aaravs-s/pharmatech/README.md

# pharmatech

Boilerplate repository structure for a pill compounding machine project.

## Top-level areas
- `cad/` - mechanical and enclosure design files
- `firmware/` - embedded software and configuration
- `electronics/` - schematic, PCB, and component documentation
