aaravs-s/pharmatech/electronics/README.md

# Electronics

Electrical design artifacts for control, power, and interface circuitry.

## Layout
- `schematics/` - source schematic files
- `pcb/` - PCB layout files and fabrication outputs
- `bom/` - bill of materials and sourcing sheets
- `simulation/` - circuit simulation setups and outputs
- `docs/` - electronics-specific engineering notes
