aaravs-s/pharmatech/cad/README.md

# CAD

Mechanical design assets for the pill compounding machine.

## Layout
- `models/` - parametric and solid model source files
- `drawings/` - manufacturing drawings and assembly views
- `exports/` - neutral exchange formats (STEP/STL/OBJ)
- `docs/` - CAD-specific notes and design decisions
