aaravs-s/pharmatech/firmware/README.md

# Firmware

Embedded software for machine control, sensing, and dosing logic.

## Layout
- `src/` - application source code
- `include/` - public headers and shared interfaces
- `config/` - board and environment configuration
- `tests/` - firmware-focused tests and test fixtures
- `docs/` - protocol and architecture notes
