aaravs-s/pharmatech/docs/journal-reference/entries/R07_model_the_two_arm_agitator_and_compare_uniform_and_tapered_flight_concepts.md

# R07 Model the two-arm agitator and compare uniform and tapered-flight concepts

> **AI-assisted reference draft — not a submitted work log.** This reconstruction is for writing your own journal from your actual work. Work dates, active hours, missing measurements, and test claims must be completed from your records. Archived CAD screenshots were captured retrospectively on October 13, 2026; they are not original screenshots from the design session.

Milestone 1 · Previous topics J12

Work date: [your actual date]
Active work time: [your actual hours; group/split by real sessions]

## Objective

Add hopper circulation to the auger drive and preserve the distinction between a modeled configuration and a proposed alternative.

## Design process

I developed agitator arms that could rotate with the auger-related drive component. The additional design note asks for two agitators attached to the rotating piece so both the auger and agitation move together. The saved CAD views show an auger with two triangular arms, which gives me a concrete image for explaining that arrangement.

I also explored a second auger configuration with flights that taper rather than remaining uniform along the shaft. The purpose was to compare feeding geometries instead of assuming the first spiral shape would suit every powder. The design note describes the intended alternatives, but it does not confirm that both were printed or tested successfully.

The arm geometry needs to be described in relation to the hopper: sweep diameter, axial position, clearance from the walls, and the connection that transfers torque. Those dimensions determine what material the agitator can disturb. This update is a useful place to separate a CAD proposal from the version that eventually ran in a physical powder test.

## Construction and implementation detail

The planning note proposed attaching the agitator beneath the rotating blue component so that one rotating connection could turn both the auger and agitation features. It called for two arms and two configurations: a screw similar to the existing one with added agitators, and another with flights that funnel downward. That note is specific about the intended relationship among parts but does not demonstrate that both configurations were successfully printed and tested.

The V5 feature history shows the arm geometry in Sketch 10 on the Top plane. The construction view highlights the arm profiles around the existing shaft and screw. Extrude 8 then selects two faces of that sketch, uses Add, enables Symmetric extrusion, sets the displayed depth to 0.318 cm, and merges into the part named tube adapter. The archived depth is approximately 3.18 mm. Recreating this feature requires the arm sketch and merge target as well as the thickness.

The open triangular arms shown in the model expand the rotating sweep beyond the screw itself. Their purpose is to encounter powder outside the narrow auger region and cycle it toward the feeder. Arm reach therefore has to be assessed in the hopper's coordinate system rather than judged from the isolated part. A good assembly check would display the hopper wall and the arm envelope together and measure the minimum gap around a full rotation.

I kept the uniform screw and tapered proposal distinct in the reference sequence. The recovered Helix 1 uses one target pitch along a defined height, whereas the planning text requests a funneling variation. Without the separate alternative's feature definition or print image, I cannot use the constant-pitch sweep screenshot as proof of a tapered flight. The image placeholder names the missing alternative rather than implying it is in the final view.

Adding arms also introduced a mechanical load change. The drive now moved the screw and encountered powder through the agitator at the same time. That made loaded rotation, powder accumulation near the arm roots, and the printed attachment points relevant to later speed testing. The notes describe agitation helping with clumps, but do not record stresses or a measured power comparison.

This completed the mechanical reasoning needed to enter closed-loop development: a single powder path, an auger that could be driven, and an agitation concept addressing stagnant material. M2 still required independent work on wiring, reading the scale, selecting commands, and stopping correctly. Those stages follow as individual detailed updates rather than one jump from finished mechanism to working electronics.

## Image sequence

V5 agitator: Sketch 10 highlights the two arm profiles before Extrude 8, with the earlier screw geometry present.

V5 agitator: Sketch 10 highlights the two arm profiles before Extrude 8, with the earlier screw geometry present.

V5 agitator: Extrude 8 adds two sketch faces symmetrically at 0.318 cm depth into tube adapter. The archived tree shows feature warnings, not a fully validated assembly.

V5 agitator: Extrude 8 adds two sketch faces symmetrically at 0.318 cm depth into tube adapter. The archived tree shows feature warnings, not a fully validated assembly.

V5 Part Studio 1, saved July 2 2026. Auger geometry with two agitator arms.

V5 Part Studio 1, saved July 2 2026. Auger geometry with two agitator arms.

V10 Part Studio 1, saved July 10 2026. Later view of the auger and agitator arms.

V10 Part Studio 1, saved July 10 2026. Later view of the auger and agitator arms.

## Result and handoff

The V5 archive contains a two-arm agitator constructed from a sketch and symmetric additive extrusion. The separate tapered-flight concept still needs its own model and test evidence.

## Complete from your records

Add arm tip radius, measured wall clearance, attachment geometry, printed revision, and observed results for each of the two proposed configurations.

[IMAGE PLACEHOLDER: Assembly section showing agitator tips relative to the hopper wall throughout rotation.]

[IMAGE PLACEHOLDER: Tapered-flight alternative: its generating sketch/path, intermediate solid, finished CAD, and printed comparison.]

## Sources

- [M1 - MECHANICAL DOSER](https://docs.google.com/document/d/1VJVmuO_Wsarp4JEZYmcffV4hj5R7lj_xGEI08EhueAM/edit)
- [STUFF TO FIX TONIGHT](https://docs.google.com/document/d/1usu-M_TCbRc7j5A3ndAVeFQoTAXTW40O4JjwxquL32A/edit)

[All reference drafts](../README.md) · [Image URLs](../IMAGE_URLS.md) · [Project journal](../../../JOURNAL.md)
