aaravs-s/pharmatech/Images/CadModel.png

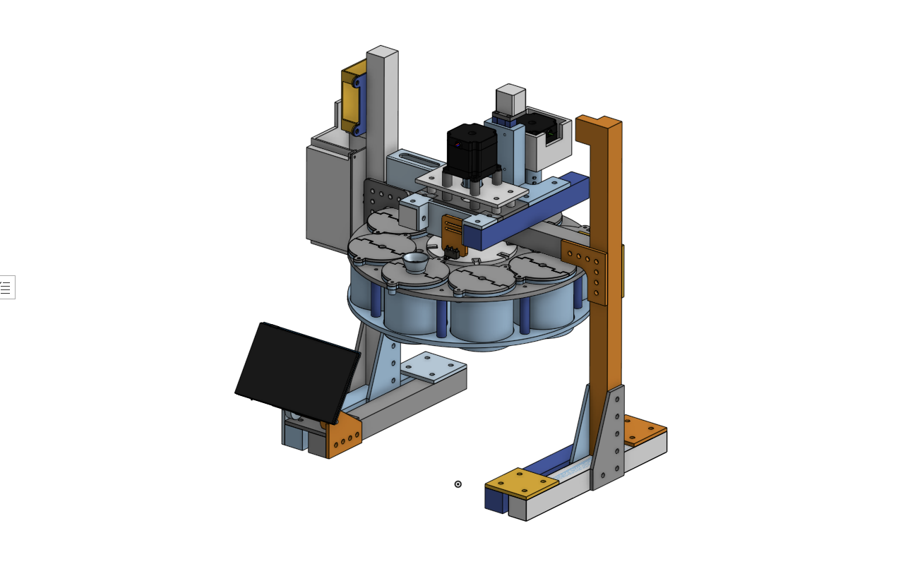
Images/CadModel.png
