aaravs-s/pharmatech/docs/journal-reference/session_worksheet.csv

Reference update | Title | Previous outline topics | Actual session date | Actual active hours | Split/combined session | Files/revisions used | Measured result | Missing evidence supplied
R01 | Define the requirements and develop the shared eight-hopper architecture | J01; J02; J03
R02 | Construct the first hopper, adapter, and bottom-feeder CAD | J05
R03 | Build the auger from a helix and flight profile, then obtain a usable print | J04
R04 | Test the removable threaded hopper and replace it with a short locking interface | J06; J07
R05 | Simplify the powder path and reduce sugar leaking during loading | J08; J09
R06 | Diagnose cornstarch jamming and the first agitator's incomplete coverage | J10; J11
R07 | Model the two-arm agitator and compare uniform and tapered-flight concepts | J12
R08 | Wire the first NEMA 17 and TMC2209 drive and establish controlled motion | J13
R09 | Read serial scale data and establish the baseline mass for each dispense | J14
R10 | Build the touchscreen workflow and hand targets to a separate controller process | J15; J16
R11 | Replace continuous feeding near the target with stop, settle, and pulse phases | J17
R12 | Separate powder behavior into configurable motion and settling profiles | J18
R13 | Stop unwanted motion after program termination and add layered shutdown behavior | J19
R14 | Plan the electronics mounting and PCB while the control system is still changing | J20
R15 | Investigate loaded speed limits and upgrade the NEMA 17 drive | J21; J22
R16 | Make phase thresholds depend on dose size: the July 21 to July 24 controller revision | J23
R17 | Replace the barcode plan with selectable profiles and run the doser from the Pi | J24; J25
R18 | Measure 5 g performance with sugar, salt, cocoa, and cinnamon | J26; J27
R19 | Validate 5 g dispensing of the four cohesive powders | J28
R20 | Evaluate the 0.055 g limit and separate accuracy from repeatability | J29; J30
R21 | Build the solid eight-pocket carousel and evolve it into an open two-plate structure | J31
R22 | Develop the lift mechanism that clears the drive before indexing | J32
R23 | Replace the angle-sensitive drive coupling with serrated mating teeth | J33; J34
R24 | Construct the extrusion frame and integrate the carousel, scale, lift, and screen | J35; J36
R25 | Convert carousel positions to step counts and establish a known reference | J37; J38
R26 | Choose the shortest carousel route and wait for completed indexing | J39
R27 | Sequence lift, indexing, engagement, and mass feedback for a multi-powder recipe | J40
R28 | Move STEP generation from the software loop to hardware timers | J41; J42
R29 | Add driver-alarm handling and an interactive motor-speed test | J43
R30 | Drop the fixed-board plan, troubleshoot perfboard, and mount a half-size breadboard | J44; J45
R31 | Design protective covers and consolidate wiring along the frame | J46
R32 | Write an operating and cleaning procedure consistent with the actual prototype | J47
R33 | Document the final integrated state and identify exactly what was demonstrated | J48
