aaravs-s/pharmatech/docs/journal-reference/README.md

# Pill Compounder Journal References

These 33 AI-assisted drafts reconstruct the design process from milestone notes, archived CAD, and recovered source files. They are reference material for the author to write their own entries; they are not verified dated sessions or grant submissions.

The image files are hosted in this repository. Every embedded image below uses an absolute raw GitHub URL so that the same Markdown can be used on external sites that permit remote images.

- [Project journal](../../JOURNAL.md)
- [Image gallery](GALLERY.md)
- [Copyable image URLs](IMAGE_URLS.md)
- [Evidence and version distinctions](EVIDENCE.md)
- [Actual-session worksheet](session_worksheet.csv)
- [Recorded powder results](powder_results.csv)

## Reference drafts

| Reference | Milestone | Topic |
| --- | --- | --- |
| R01 | 1 | [Define the requirements and develop the shared eight-hopper architecture](entries/R01_define_the_requirements_and_develop_the_shared_eight_hopper_architecture.md) |
| R02 | 1 | [Construct the first hopper, adapter, and bottom-feeder CAD](entries/R02_construct_the_first_hopper_adapter_and_bottom_feeder_cad.md) |
| R03 | 1 | [Build the auger from a helix and flight profile, then obtain a usable print](entries/R03_build_the_auger_from_a_helix_and_flight_profile_then_obtain_a_usable_print.md) |
| R04 | 1 | [Test the removable threaded hopper and replace it with a short locking interface](entries/R04_test_the_removable_threaded_hopper_and_replace_it_with_a_short_locking_interface.md) |
| R05 | 1 | [Simplify the powder path and reduce sugar leaking during loading](entries/R05_simplify_the_powder_path_and_reduce_sugar_leaking_during_loading.md) |
| R06 | 1 | [Diagnose cornstarch jamming and the first agitator's incomplete coverage](entries/R06_diagnose_cornstarch_jamming_and_the_first_agitator_s_incomplete_coverage.md) |
| R07 | 1 | [Model the two-arm agitator and compare uniform and tapered-flight concepts](entries/R07_model_the_two_arm_agitator_and_compare_uniform_and_tapered_flight_concepts.md) |
| R08 | 2 | [Wire the first NEMA 17 and TMC2209 drive and establish controlled motion](entries/R08_wire_the_first_nema_17_and_tmc2209_drive_and_establish_controlled_motion.md) |
| R09 | 2 | [Read serial scale data and establish the baseline mass for each dispense](entries/R09_read_serial_scale_data_and_establish_the_baseline_mass_for_each_dispense.md) |
| R10 | 2 | [Build the touchscreen workflow and hand targets to a separate controller process](entries/R10_build_the_touchscreen_workflow_and_hand_targets_to_a_separate_controller_process.md) |
| R11 | 2 | [Replace continuous feeding near the target with stop, settle, and pulse phases](entries/R11_replace_continuous_feeding_near_the_target_with_stop_settle_and_pulse_phases.md) |
| R12 | 2 | [Separate powder behavior into configurable motion and settling profiles](entries/R12_separate_powder_behavior_into_configurable_motion_and_settling_profiles.md) |
| R13 | 2 | [Stop unwanted motion after program termination and add layered shutdown behavior](entries/R13_stop_unwanted_motion_after_program_termination_and_add_layered_shutdown_behavior.md) |
| R14 | 2 | [Plan the electronics mounting and PCB while the control system is still changing](entries/R14_plan_the_electronics_mounting_and_pcb_while_the_control_system_is_still_changing.md) |
| R15 | 3 | [Investigate loaded speed limits and upgrade the NEMA 17 drive](entries/R15_investigate_loaded_speed_limits_and_upgrade_the_nema_17_drive.md) |
| R16 | 3 | [Make phase thresholds depend on dose size: the July 21 to July 24 controller revision](entries/R16_make_phase_thresholds_depend_on_dose_size_the_july_21_to_july_24_controller_revision.md) |
| R17 | 3 | [Replace the barcode plan with selectable profiles and run the doser from the Pi](entries/R17_replace_the_barcode_plan_with_selectable_profiles_and_run_the_doser_from_the_pi.md) |
| R18 | 3 | [Measure 5 g performance with sugar, salt, cocoa, and cinnamon](entries/R18_measure_5_g_performance_with_sugar_salt_cocoa_and_cinnamon.md) |
| R19 | 3 | [Validate 5 g dispensing of the four cohesive powders](entries/R19_validate_5_g_dispensing_of_the_four_cohesive_powders.md) |
| R20 | 3 | [Evaluate the 0.055 g limit and separate accuracy from repeatability](entries/R20_evaluate_the_0_055_g_limit_and_separate_accuracy_from_repeatability.md) |
| R21 | 4 | [Build the solid eight-pocket carousel and evolve it into an open two-plate structure](entries/R21_build_the_solid_eight_pocket_carousel_and_evolve_it_into_an_open_two_plate_structure.md) |
| R22 | 4 | [Develop the lift mechanism that clears the drive before indexing](entries/R22_develop_the_lift_mechanism_that_clears_the_drive_before_indexing.md) |
| R23 | 4 | [Replace the angle-sensitive drive coupling with serrated mating teeth](entries/R23_replace_the_angle_sensitive_drive_coupling_with_serrated_mating_teeth.md) |
| R24 | 4 | [Construct the extrusion frame and integrate the carousel, scale, lift, and screen](entries/R24_construct_the_extrusion_frame_and_integrate_the_carousel_scale_lift_and_screen.md) |
| R25 | 4 | [Convert carousel positions to step counts and establish a known reference](entries/R25_convert_carousel_positions_to_step_counts_and_establish_a_known_reference.md) |
| R26 | 4 | [Choose the shortest carousel route and wait for completed indexing](entries/R26_choose_the_shortest_carousel_route_and_wait_for_completed_indexing.md) |
| R27 | 4 | [Sequence lift, indexing, engagement, and mass feedback for a multi-powder recipe](entries/R27_sequence_lift_indexing_engagement_and_mass_feedback_for_a_multi_powder_recipe.md) |
| R28 | 5 | [Move STEP generation from the software loop to hardware timers](entries/R28_move_step_generation_from_the_software_loop_to_hardware_timers.md) |
| R29 | 5 | [Add driver-alarm handling and an interactive motor-speed test](entries/R29_add_driver_alarm_handling_and_an_interactive_motor_speed_test.md) |
| R30 | 5 | [Drop the fixed-board plan, troubleshoot perfboard, and mount a half-size breadboard](entries/R30_drop_the_fixed_board_plan_troubleshoot_perfboard_and_mount_a_half_size_breadboard.md) |
| R31 | 5 | [Design protective covers and consolidate wiring along the frame](entries/R31_design_protective_covers_and_consolidate_wiring_along_the_frame.md) |
| R32 | 5 | [Write an operating and cleaning procedure consistent with the actual prototype](entries/R32_write_an_operating_and_cleaning_procedure_consistent_with_the_actual_prototype.md) |
| R33 | 5 | [Document the final integrated state and identify exactly what was demonstrated](entries/R33_document_the_final_integrated_state_and_identify_exactly_what_was_demonstrated.md) |

## Using the references

Write your own account of the actual work, replace the missing details with real observations, and record the original work date and active time. Keep retrospective screenshot capture dates separate from design-session dates. The number or length of reference drafts is not a count of verified sessions or hours.

The early reference topics overlap the four Forge entries already published. Avoid counting the same work again.

The images are committed as individual files, not stored only in a ZIP. Keep their paths stable if you reuse the raw URLs.
