aaravs-s/pharmatech/docs/journals/J27_sequence_lift_indexing_engagement_and_mass_feedback_for_a_multi_powder_recipe.md

# J27 Getting the recipe to wait for the mechanisms

*Milestone 4 | Retrospective build notes*

Moving from one powder to a recipe made the application more demanding. It had to know the contents of each slot, the requested amount, and where the mechanisms were before it could even start the next dispense.

I used the same basic sequence I had been building mechanically: raise, index, lower, feed. The app waits at the boundaries instead of firing all the commands and assuming the hardware keeps up. If the actuator position is unknown, it doesn't go on with an invented position.

Physical multi-doser assembly photograph included in M4.

Physical multi-doser assembly photograph included in M4.

Cancellation was another awkward edge. The actuator has its own controller, so STOP ALL on the Uno isn't a stop for the whole machine. The app has to reach both devices and stop trusting position after interruption.

For the mass, each ingredient needs a new starting reference. Otherwise powder already in the cup could be mistaken for part of the next addition. The app also has CSV fields for per-item results. I don't have a complete measured recipe tied to one matched final software set here, so those fields are a logging feature rather than a result table I can populate from the single-powder trials.

## The preparation sequence

The later app builds active_run_items from slots with a positive requested amount, preserving each slot's powder name and target. It initializes per-item dispensed, remaining, and status values, computes the total recipe target, clears cancellation events, and begins preparing the first item. That is the data model behind the multi-powder workflow.

The preparation worker first checks cancellation and actuator state. If the actuator is UNKNOWN, it refuses to continue. If it isn't UP, it sends ACTUATOR UP and waits for a motion response with a 70 s timeout. If it is already UP, it checks status and handles the source's declared reference procedure. Only then does it request DISK GOTO for the next item.

Disk motion has a 12 s timeout in the recipe worker. The returned line must contain DONE DISK SLOT with the requested slot number. Once that is confirmed, the app records the slot, checks cancellation again, sends ACTUATOR DOWN, waits for completion, and queues a ready result. The main UI then launches mass dispensing for the item. This is an explicit raise/index/lower/feed chain with completion checks between actions.

The actuator has a separate controller, so Uno STOP ALL doesn't stop every moving mechanism by itself. The app's force-stop route also sends an actuator stop and marks actuator and disk state unknown. Cancellation checks between stages prevent a canceled preparation sequence from proceeding through the remaining actions on its old assumptions.

After all recipe items have dispensed, preparation is called with no next item; the worker raises the actuator and queues completion. The app exports per-item results to CSV, including target, actual mass, error, remaining amount, and status. Those fields can document a real integrated trial, but their presence in source code doesn't prove that such a trial occurred successfully.

## More views

Current Main workspace SuperStructureAssem. Only one hopper is visible in this assembly view. CAD includes mate or linked-reference warnings; the image is not proof of a fully populated or validated mechanism.

Current Main workspace SuperStructureAssem. Only one hopper is visible in this assembly view. CAD includes mate or linked-reference warnings; the image is not proof of a fully populated or validated mechanism.

Full frame, carousel, drive, and screen CAD from M4.

Full frame, carousel, drive, and screen CAD from M4.

## Code for this revision

Exact archived source excerpts. The file labels identify their revisions.

### app_later.py · lines 959–997

Recovered full later Library app; contains automatic recipes, serial discovery, and switch-indexing wording.

```python
def _prepare_recipe_item_worker(item):
    global actuator_position, disk_current_slot, disk_position_known
    try:
        _check_recipe_cancelled()
        if actuator_position == "UNKNOWN":
            raise RuntimeError("Linear actuator position is UNKNOWN. Return it to the top "
                               "and use SET CURRENT AS UP before restarting the recipe.")
        if actuator_position != "UP":
            _recipe_status("Raising the linear actuator 69,000 steps before disk movement...")
            _perform_actuator_command("ACTUATOR UP", response_type="motion", timeout=70.0)
            actuator_position = "UP"
        else:
            status = _perform_actuator_command("ACTUATOR STATUS", response_type="status", timeout=3.0)
            if "POSITION=UNKNOWN" in status:
                _perform_actuator_command("SET ACTUATOR UP", response_type="ok", timeout=2.0)
            elif "POSITION=UP" not in status:
                raise RuntimeError(f"XIAO did not confirm the actuator is UP: {status}")
        _check_recipe_cancelled()
        if item is None:
            recipe_result_queue.put(("complete", None))
            return
        target_slot = item["slot"]
        _recipe_status(f"Actuator is UP. Moving disk to slot {target_slot}: {item['name']}...")
        disk_response = _perform_disk_command(f"DISK GOTO {target_slot}", response_type="motion", timeout=12.0)
        match = re.search(r"DONE DISK SLOT\s+(\d+)", disk_response)
        if not match or int(match.group(1)) != target_slot:
            raise RuntimeError(f"Disk did not confirm slot {target_slot}: {disk_response}")
        disk_current_slot = target_slot
        disk_position_known = True
        _check_recipe_cancelled()
        _recipe_status(f"Disk is at slot {target_slot}. Lowering the actuator 69,000 steps before dispensing...")
        _perform_actuator_command("ACTUATOR DOWN", response_type="motion", timeout=70.0)
        actuator_position = "DOWN"
        _check_recipe_cancelled()
        recipe_result_queue.put(("ready", item))
    except RecipeSequenceCancelled as exc:
        recipe_result_queue.put(("cancelled", str(exc)))
    except Exception as exc:
        recipe_result_queue.put(("error", str(exc)))
```

### app_later.py · lines 1035–1047

Recovered full later Library app; contains automatic recipes, serial discovery, and switch-indexing wording.

```python
def start_recipe_preparation():
    if not recipe_run_active or recipe_cancel_event.is_set():
        return
    if recipe_run_index < len(active_run_items):
        item = active_run_items[recipe_run_index]
        message = (f"Preparing item {recipe_run_index + 1} of {len(active_run_items)}: "
                   f"Slot {item['slot']} — {item['name']}")
    else:
        item = None
        message = "All powders are dispensed. Returning the actuator to UP..."
    recipe_motion_screen(message)
    threading.Thread(target=_prepare_recipe_item_worker, args=(item,), daemon=True).start()
    root.after(100, process_recipe_result_queue)
```

The recipe logic was mostly about making each stage earn the next one: known position, completed movement, then feeding. That is much more than adding eight quantities to the screen. The remaining gap in this record is the matched firmware and full run data needed to check the whole sequence together.

<details>
<summary>Notes added while reconstructing this entry</summary>

The final paired actuator firmware, disk firmware, and measured recipe transcript aren't identified in the available archive. In particular, switch-based app wording differs from the recovered step-count disk code. The state and command flow above describe the saved implementation without asserting that an arbitrary combination of those files is a validated final build.

</details>

## Sources

- [M4: Multi-doser compounding](https://docs.google.com/document/d/1j8LOm5HRvMM-VXsni-38hi5GsA0yg5A1A_3LY9DY1Is/edit)
- [Existing Forge journals](https://forge.hackclub.com/projects/763)

[Corresponding reference and evidence gaps](https://github.com/aaravs-s/pharmatech/blob/main/docs/journal-reference/entries/R27_sequence_lift_indexing_engagement_and_mass_feedback_for_a_multi_powder_recipe.md)

CAD construction captures are retrospective inspections of saved models, captured on October 13, 2026. They are not contemporaneous design-session screenshots.

[Journal collection](README.md) | [Original references](../journal-reference/README.md) | [Project journal](../../JOURNAL.md)
