aaravs-s/pharmatech/docs/journal-reference/GALLERY.md

# Journal reference image gallery

[Reference index](README.md) · [Copyable image URLs](IMAGE_URLS.md)

New CAD construction captures were taken retrospectively on October 13, 2026. Individual captions identify the model/version where available.

## cad_b4_assembly.jpg

B4 workspace SuperStructureAssem. The alternate arrangement shows a servo and lead-screw lift structure above the auger drive. This is a CAD revision, not proof of installed final hardware.

B4 workspace SuperStructureAssem. The alternate arrangement shows a servo and lead-screw lift structure above the auger drive. This is a CAD revision, not proof of installed final hardware.

[Original source](https://cad.onshape.com/documents/f819db58872866a35406a666/w/1f6b807ce727fc3c6c64753e/e/10f304238bc42744937828a5)

## cad_b4_lift.jpg

B4 servo actuator assem. CAD of the lift concept with lead screw, brackets, and motor assembly. Confirm its relationship to the built mechanism.

B4 servo actuator assem. CAD of the lift concept with lead screw, brackets, and motor assembly. Confirm its relationship to the built mechanism.

[Original source](https://cad.onshape.com/documents/f819db58872866a35406a666/w/1f6b807ce727fc3c6c64753e/e/0298b1384aee3baf88b3c44e)

## cad_doser_early_assembly.jpg

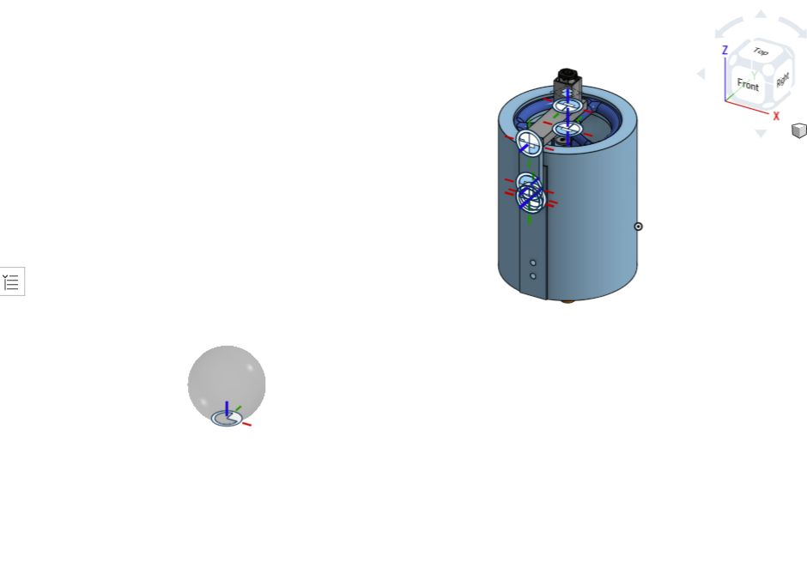
[picture p60: docs/journal-reference/assets/cad_doser_early_assembly.jpg]
Separate doser document, simple asem tab. It shows a single hopper assembly and visibly unresolved mate markers in the source UI.


Separate doser document, simple asem tab. It shows a single hopper assembly and visibly unresolved mate markers in the source UI.

[Original source](https://cad.onshape.com/documents/402cc719a9b371e4776378d7/w/02bcbbb697ba2949cb4b8289/e/e7f1ae54d13c5c78b7393eca)

## cad_main_assembly.jpg

Current Main workspace SuperStructureAssem. Only one hopper is visible in this assembly view. CAD includes mate or linked-reference warnings; the image is not proof of a fully populated or validated mechanism.

Current Main workspace SuperStructureAssem. Only one hopper is visible in this assembly view. CAD includes mate or linked-reference warnings; the image is not proof of a fully populated or validated mechanism.

[Original source](https://cad.onshape.com/documents/f819db58872866a35406a666/w/7d1b7ca1a3232135829d3d22/e/10f304238bc42744937828a5)

## cad_main_rotary.jpg

Current Rotary Disk V2 Part Studio showing eight openings, two plates, spacers, and central indexing features.

Current Rotary Disk V2 Part Studio showing eight openings, two plates, spacers, and central indexing features.

[Original source](https://cad.onshape.com/documents/f819db58872866a35406a666/w/7d1b7ca1a3232135829d3d22/e/109c5c7082df4704b0ae719e)

## cad_main_superstructure.jpg

Current Main workspace Superstructure Part Studio. CAD geometry capture, not a validated structural test.

Current Main workspace Superstructure Part Studio. CAD geometry capture, not a validated structural test.

[Original source](https://cad.onshape.com/documents/f819db58872866a35406a666/w/7d1b7ca1a3232135829d3d22/e/600e8b7745e9207ed96bca89)

## cad_v10_auger_agitator.jpg

V10 Part Studio 1, saved July 10 2026. Later view of the auger and agitator arms.

V10 Part Studio 1, saved July 10 2026. Later view of the auger and agitator arms.

[Original source](https://cad.onshape.com/documents/f819db58872866a35406a666/v/b12403b67299534bef1edc27/e/f71758db9526cabee3bf909f)

## cad_v18_adapter_base_extrude.jpg

V18 motor adapter: Extrude 13 adds two selected Sketch 15 regions at 0.2 cm blind depth into Part 4.

V18 motor adapter: Extrude 13 adds two selected Sketch 15 regions at 0.2 cm blind depth into Part 4.

[Original source](https://cad.onshape.com/documents/f819db58872866a35406a666/v/7212cfc1b8972a4d6cbc3e1b/e/a4c2e4728cc4a7298ef15cd1)

## cad_v18_adapter_base_sketch.jpg

V18 auger motor adapter: Sketch 15 on a face of Extrude 2, displayed 2.5 cm circular profile before the adapter base is added.

V18 auger motor adapter: Sketch 15 on a face of Extrude 2, displayed 2.5 cm circular profile before the adapter base is added.

[Original source](https://cad.onshape.com/documents/f819db58872866a35406a666/v/7212cfc1b8972a4d6cbc3e1b/e/a4c2e4728cc4a7298ef15cd1)

## cad_v18_adapter_complete.jpg

V18 saved auger with keyed motor adapter. This is a recovered orientation-dependent design stage; its identity with the exact failed printed coupler has not been established, and it is not the later serrated revision.

V18 saved auger with keyed motor adapter. This is a recovered orientation-dependent design stage; its identity with the exact failed printed coupler has not been established, and it is not the later serrated revision.

[Original source](https://cad.onshape.com/documents/f819db58872866a35406a666/v/7212cfc1b8972a4d6cbc3e1b/e/a4c2e4728cc4a7298ef15cd1)

## cad_v18_adapter_key_extrude.jpg

V18 motor adapter: Extrude 11 adds two Sketch 13 regions at 0.75 cm blind depth into Part 4, forming the keyed wall/engagement geometry.

V18 motor adapter: Extrude 11 adds two Sketch 13 regions at 0.75 cm blind depth into Part 4, forming the keyed wall/engagement geometry.

[Original source](https://cad.onshape.com/documents/f819db58872866a35406a666/v/7212cfc1b8972a4d6cbc3e1b/e/a4c2e4728cc4a7298ef15cd1)

## cad_v18_adapter_key_sketch.jpg

V18 motor adapter: Sketch 13 on a face of Extrude 13 shows a 2.3 cm circular boundary and keyed engagement profile. Onshape reports this sketch is not fully defined.

V18 motor adapter: Sketch 13 on a face of Extrude 13 shows a 2.3 cm circular boundary and keyed engagement profile. Onshape reports this sketch is not fully defined.

[Original source](https://cad.onshape.com/documents/f819db58872866a35406a666/v/7212cfc1b8972a4d6cbc3e1b/e/a4c2e4728cc4a7298ef15cd1)

## cad_v18_disk_complete.jpg

V18 saved Rotary Disk V2 after closing its feature preview. The archive contains feature warnings; this view is geometry evidence, not a rigidity or operation test.

V18 saved Rotary Disk V2 after closing its feature preview. The archive contains feature warnings; this view is geometry evidence, not a rigidity or operation test.

[Original source](https://cad.onshape.com/documents/f819db58872866a35406a666/v/7212cfc1b8972a4d6cbc3e1b/e/109c5c7082df4704b0ae719e)

## cad_v18_disk_lightening.jpg

V18 Rotary Disk V2: Part Lightening feature inspected as a construction stage, with its parameters and cut structure shown.

V18 Rotary Disk V2: Part Lightening feature inspected as a construction stage, with its parameters and cut structure shown.

[Original source](https://cad.onshape.com/documents/f819db58872866a35406a666/v/7212cfc1b8972a4d6cbc3e1b/e/109c5c7082df4704b0ae719e)

## cad_v18_disk_mirror.jpg

V18 Rotary Disk V2: Mirror 1 duplicates the selected plate about Plane 1, producing the upper/lower arrangement.

V18 Rotary Disk V2: Mirror 1 duplicates the selected plate about Plane 1, producing the upper/lower arrangement.

[Original source](https://cad.onshape.com/documents/f819db58872866a35406a666/v/7212cfc1b8972a4d6cbc3e1b/e/109c5c7082df4704b0ae719e)

## cad_v18_disk_plane.jpg

V18 Rotary Disk V2: Plane 1 parameter view defining the reference used by Mirror 1. Read-only historical inspection.

V18 Rotary Disk V2: Plane 1 parameter view defining the reference used by Mirror 1. Read-only historical inspection.

[Original source](https://cad.onshape.com/documents/f819db58872866a35406a666/v/7212cfc1b8972a4d6cbc3e1b/e/109c5c7082df4704b0ae719e)

## cad_v18_disk_plate.jpg

V18 Rotary Disk V2: Extrude 1 creates the initial plate from Sketch 1 regions. Historical construction preview.

V18 Rotary Disk V2: Extrude 1 creates the initial plate from Sketch 1 regions. Historical construction preview.

[Original source](https://cad.onshape.com/documents/f819db58872866a35406a666/v/7212cfc1b8972a4d6cbc3e1b/e/109c5c7082df4704b0ae719e)

## cad_v18_disk_sketch.jpg

V18 Rotary Disk V2: Sketch 1 on Top plane. The displayed outer diameter is 33 cm and a pocket diameter is 8.5 cm; the rest of the crowded dimensions need direct CAD inspection.

V18 Rotary Disk V2: Sketch 1 on Top plane. The displayed outer diameter is 33 cm and a pocket diameter is 8.5 cm; the rest of the crowded dimensions need direct CAD inspection.

[Original source](https://cad.onshape.com/documents/f819db58872866a35406a666/v/7212cfc1b8972a4d6cbc3e1b/e/109c5c7082df4704b0ae719e)

## cad_v18_frame_baseplates.jpg

V18 frame: Extrude 3 creates plate geometry at 0.5 cm depth; previously created rails and uprights remain in the construction preview.

V18 frame: Extrude 3 creates plate geometry at 0.5 cm depth; previously created rails and uprights remain in the construction preview.

[Original source](https://cad.onshape.com/documents/f819db58872866a35406a666/v/7212cfc1b8972a4d6cbc3e1b/e/600e8b7745e9207ed96bca89)

## cad_v18_frame_complete.jpg

V18 saved Superstructure after closing the feature preview. This historical model is distinct from the later Main assembly.

V18 saved Superstructure after closing the feature preview. This historical model is distinct from the later Main assembly.

[Original source](https://cad.onshape.com/documents/f819db58872866a35406a666/v/7212cfc1b8972a4d6cbc3e1b/e/600e8b7745e9207ed96bca89)

## cad_v18_frame_rails.jpg

V18 frame: Extrude 1 creates the first base rail solids from selected Sketch 1 faces, blind depth 3 cm.

V18 frame: Extrude 1 creates the first base rail solids from selected Sketch 1 faces, blind depth 3 cm.

[Original source](https://cad.onshape.com/documents/f819db58872866a35406a666/v/7212cfc1b8972a4d6cbc3e1b/e/600e8b7745e9207ed96bca89)

## cad_v18_frame_sketch.jpg

V18 frame: Sketch 1 on Top plane, including rail/attachment layout and visible 50 and 35 dimensions in the centimetre-based model.

V18 frame: Sketch 1 on Top plane, including rail/attachment layout and visible 50 and 35 dimensions in the centimetre-based model.

[Original source](https://cad.onshape.com/documents/f819db58872866a35406a666/v/7212cfc1b8972a4d6cbc3e1b/e/600e8b7745e9207ed96bca89)

## cad_v18_frame_uprights.jpg

V18 frame: Extrude 2 creates four upright solids from Sketch 1 faces at 48 cm blind depth.

V18 frame: Extrude 2 creates four upright solids from Sketch 1 faces at 48 cm blind depth.

[Original source](https://cad.onshape.com/documents/f819db58872866a35406a666/v/7212cfc1b8972a4d6cbc3e1b/e/600e8b7745e9207ed96bca89)

## cad_v1_adapter_extrude.jpg

V1 adapter: Extrude 2, New solid, depth 5.118 in, starting offset 0.197 in. Read-only feature construction preview.

V1 adapter: Extrude 2, New solid, depth 5.118 in, starting offset 0.197 in. Read-only feature construction preview.

[Original source](https://cad.onshape.com/documents/f819db58872866a35406a666/v/c35bd3df92eaaba4c30c0348/e/f71758db9526cabee3bf909f)

## cad_v1_complete.jpg

V1 complete saved feeder model, after closing the feature preview. Holder, adapter, and bottom feeder are present.

V1 complete saved feeder model, after closing the feature preview. Holder, adapter, and bottom feeder are present.

[Original source](https://cad.onshape.com/documents/f819db58872866a35406a666/v/c35bd3df92eaaba4c30c0348/e/f71758db9526cabee3bf909f)

## cad_v1_feeder.jpg

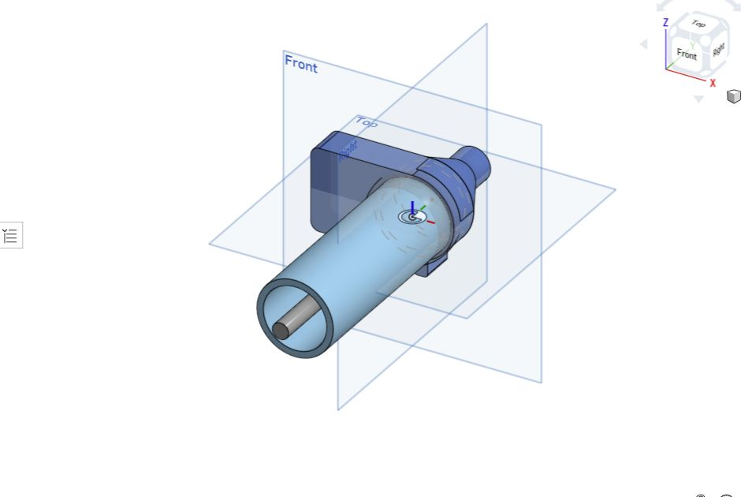
[picture p61: docs/journal-reference/assets/cad_v1_feeder.jpg]
V1 Part Studio 1, saved June 21 2026. Early feeder geometry.


V1 Part Studio 1, saved June 21 2026. Early feeder geometry.

[Original source](https://cad.onshape.com/documents/f819db58872866a35406a666/v/c35bd3df92eaaba4c30c0348/e/f71758db9526cabee3bf909f)

## cad_v1_feeder_revolve.jpg

V1 feeder: Revolve 1 adds faces of Sketch 6 around its selected edge, full revolve, merged into bottom feeder.

V1 feeder: Revolve 1 adds faces of Sketch 6 around its selected edge, full revolve, merged into bottom feeder.

[Original source](https://cad.onshape.com/documents/f819db58872866a35406a666/v/c35bd3df92eaaba4c30c0348/e/f71758db9526cabee3bf909f)

## cad_v1_hopper_extrude.jpg

V1 holder: Extrude 1, New solid, blind depth 4.724 in. Read-only feature construction preview.

V1 holder: Extrude 1, New solid, blind depth 4.724 in. Read-only feature construction preview.

[Original source](https://cad.onshape.com/documents/f819db58872866a35406a666/v/c35bd3df92eaaba4c30c0348/e/f71758db9526cabee3bf909f)

## cad_v1_hopper_sketch.jpg

V1 holder: Sketch 2 on Front plane, before holder extrusion; displayed concentric diameters approximately 1.476 in and 1.777 in.

V1 holder: Sketch 2 on Front plane, before holder extrusion; displayed concentric diameters approximately 1.476 in and 1.777 in.

[Original source](https://cad.onshape.com/documents/f819db58872866a35406a666/v/c35bd3df92eaaba4c30c0348/e/f71758db9526cabee3bf909f)

## cad_v5_agitator_extrude.jpg

V5 agitator: Extrude 8 adds two sketch faces symmetrically at 0.318 cm depth into tube adapter. The archived tree shows feature warnings, not a fully validated assembly.

V5 agitator: Extrude 8 adds two sketch faces symmetrically at 0.318 cm depth into tube adapter. The archived tree shows feature warnings, not a fully validated assembly.

[Original source](https://cad.onshape.com/documents/f819db58872866a35406a666/v/5bcacf0da546b272575bb130/e/f71758db9526cabee3bf909f)

## cad_v5_agitator_sketch.jpg

V5 agitator: Sketch 10 highlights the two arm profiles before Extrude 8, with the earlier screw geometry present.

V5 agitator: Sketch 10 highlights the two arm profiles before Extrude 8, with the earlier screw geometry present.

[Original source](https://cad.onshape.com/documents/f819db58872866a35406a666/v/5bcacf0da546b272575bb130/e/f71758db9526cabee3bf909f)

## cad_v5_auger_agitator.jpg

V5 Part Studio 1, saved July 2 2026. Auger geometry with two agitator arms.

V5 Part Studio 1, saved July 2 2026. Auger geometry with two agitator arms.

[Original source](https://cad.onshape.com/documents/f819db58872866a35406a666/v/5bcacf0da546b272575bb130/e/f71758db9526cabee3bf909f)

## cad_v5_disk_base_sketch.jpg

V5 solid carousel: Sketch 1, Top-plane circle with displayed diameter 33 cm, before creating the disk blank.

V5 solid carousel: Sketch 1, Top-plane circle with displayed diameter 33 cm, before creating the disk blank.

[Original source](https://cad.onshape.com/documents/f819db58872866a35406a666/v/5bcacf0da546b272575bb130/e/a5f83284d99eae74ecb0cfba)

## cad_v5_disk_blank.jpg

V5 solid carousel: Extrude 1 creates a 6 cm deep New solid disk blank before pocket removal.

V5 solid carousel: Extrude 1 creates a 6 cm deep New solid disk blank before pocket removal.

[Original source](https://cad.onshape.com/documents/f819db58872866a35406a666/v/5bcacf0da546b272575bb130/e/a5f83284d99eae74ecb0cfba)

## cad_v5_disk_complete.jpg

V5 solid carousel saved model after closing the pocket feature preview. Selected feature edges remain highlighted; later suppressed features remain visible in the tree.

V5 solid carousel saved model after closing the pocket feature preview. Selected feature edges remain highlighted; later suppressed features remain visible in the tree.

[Original source](https://cad.onshape.com/documents/f819db58872866a35406a666/v/5bcacf0da546b272575bb130/e/a5f83284d99eae74ecb0cfba)

## cad_v5_disk_pocket_cut.jpg

V5 solid carousel: Extrude 2 removes the eight pocket regions to 3 cm blind depth. Intermediate feature preview.

V5 solid carousel: Extrude 2 removes the eight pocket regions to 3 cm blind depth. Intermediate feature preview.

[Original source](https://cad.onshape.com/documents/f819db58872866a35406a666/v/5bcacf0da546b272575bb130/e/a5f83284d99eae74ecb0cfba)

## cad_v5_disk_pocket_sketch.jpg

V5 solid carousel: Sketch 2 on the disk face shows eight pockets, displayed 12 cm radial location and 7 cm diameter.

V5 solid carousel: Sketch 2 on the disk face shows eight pockets, displayed 12 cm radial location and 7 cm diameter.

[Original source](https://cad.onshape.com/documents/f819db58872866a35406a666/v/5bcacf0da546b272575bb130/e/a5f83284d99eae74ecb0cfba)

## cad_v5_flight_sketch.jpg

V5 flight section: Sketch 1 on Top plane before Sweep 1. The highlighted section supplies the profile for the helix sweep.

V5 flight section: Sketch 1 on Top plane before Sweep 1. The highlighted section supplies the profile for the helix sweep.

[Original source](https://cad.onshape.com/documents/f819db58872866a35406a666/v/5bcacf0da546b272575bb130/e/f71758db9526cabee3bf909f)

## cad_v5_flight_sweep.jpg

V5 flight: Sweep 1 adds the Sketch 1 faces along Curve 1 into tube adapter; no extra Twist or Scale is enabled.

V5 flight: Sweep 1 adds the Sketch 1 faces along Curve 1 into tube adapter; no extra Twist or Scale is enabled.

[Original source](https://cad.onshape.com/documents/f819db58872866a35406a666/v/5bcacf0da546b272575bb130/e/f71758db9526cabee3bf909f)

## cad_v5_helix.jpg

V5 screw path: Helix 1, circular edge input, 2 deg start angle, 3.81 cm height, 0.635 cm target pitch, clockwise.

V5 screw path: Helix 1, circular edge input, 2 deg start angle, 3.81 cm height, 0.635 cm target pitch, clockwise.

[Original source](https://cad.onshape.com/documents/f819db58872866a35406a666/v/5bcacf0da546b272575bb130/e/f71758db9526cabee3bf909f)

## m1_1.jpg

Printed blue threaded hopper components from the M1 notes.

Printed blue threaded hopper components from the M1 notes.

[Original source](https://docs.google.com/document/d/1VJVmuO_Wsarp4JEZYmcffV4hj5R7lj_xGEI08EhueAM/edit)

## m1_10.jpg

Early rotary and fixed-drive concept in top view.

Early rotary and fixed-drive concept in top view.

[Original source](https://docs.google.com/document/d/1VJVmuO_Wsarp4JEZYmcffV4hj5R7lj_xGEI08EhueAM/edit)

## m1_11.jpg

Earlier CAD screenshot of an auger drive assembly. Original image from the milestone document.

Earlier CAD screenshot of an auger drive assembly. Original image from the milestone document.

[Original source](https://docs.google.com/document/d/1VJVmuO_Wsarp4JEZYmcffV4hj5R7lj_xGEI08EhueAM/edit)

## m1_2.jpg

Early eight-position solid rotary disk concept from the M1 notes.

Early eight-position solid rotary disk concept from the M1 notes.

[Original source](https://docs.google.com/document/d/1VJVmuO_Wsarp4JEZYmcffV4hj5R7lj_xGEI08EhueAM/edit)

## m1_3.jpg

CAD of a hopper interface with locking features. Confirm its exact revision before identifying tabs and slots.

CAD of a hopper interface with locking features. Confirm its exact revision before identifying tabs and slots.

[Original source](https://docs.google.com/document/d/1VJVmuO_Wsarp4JEZYmcffV4hj5R7lj_xGEI08EhueAM/edit)

## m1_4.jpg

Physical single-hopper prototype during powder handling.

Physical single-hopper prototype during powder handling.

[Original source](https://docs.google.com/document/d/1VJVmuO_Wsarp4JEZYmcffV4hj5R7lj_xGEI08EhueAM/edit)

## m1_5.jpg

Annotated hopper section showing the screw-in funnel concept and internal drive.

Annotated hopper section showing the screw-in funnel concept and internal drive.

[Original source](https://docs.google.com/document/d/1VJVmuO_Wsarp4JEZYmcffV4hj5R7lj_xGEI08EhueAM/edit)

## m1_6.jpg

Printed cylindrical hopper or receiver component from the M1 notes.

Printed cylindrical hopper or receiver component from the M1 notes.

[Original source](https://docs.google.com/document/d/1VJVmuO_Wsarp4JEZYmcffV4hj5R7lj_xGEI08EhueAM/edit)

## m1_7.jpg

Single doser positioned above the balance. This photo provides setup context, not a trial result.

Single doser positioned above the balance. This photo provides setup context, not a trial result.

[Original source](https://docs.google.com/document/d/1VJVmuO_Wsarp4JEZYmcffV4hj5R7lj_xGEI08EhueAM/edit)

## m1_8.jpg

Cross-section CAD illustrating the internal hopper, auger path, and base.

Cross-section CAD illustrating the internal hopper, auger path, and base.

[Original source](https://docs.google.com/document/d/1VJVmuO_Wsarp4JEZYmcffV4hj5R7lj_xGEI08EhueAM/edit)

## m1_9.jpg

Physical auger and hopper component used to illustrate the cornstarch geometry discussion.

Physical auger and hopper component used to illustrate the cornstarch geometry discussion.

[Original source](https://docs.google.com/document/d/1VJVmuO_Wsarp4JEZYmcffV4hj5R7lj_xGEI08EhueAM/edit)

## m2_1.jpg

Electronics schematic proposal from M2. It is not evidence that a PCB was manufactured.

Electronics schematic proposal from M2. It is not evidence that a PCB was manufactured.

[Original source](https://docs.google.com/document/d/1T77pfLAAVP4tJ4OaOJhaz1ho2cAGb-1LFiVUrzH-hzI/edit)

## m2_2.jpg

Breadboard motor-control wiring in the early prototype.

Breadboard motor-control wiring in the early prototype.

[Original source](https://docs.google.com/document/d/1T77pfLAAVP4tJ4OaOJhaz1ho2cAGb-1LFiVUrzH-hzI/edit)

## m2_3.jpg

Raspberry Pi and display connection with breadboard wiring.

Raspberry Pi and display connection with breadboard wiring.

[Original source](https://docs.google.com/document/d/1T77pfLAAVP4tJ4OaOJhaz1ho2cAGb-1LFiVUrzH-hzI/edit)

## m2_4.jpg

Single-doser test arrangement with scale, screen, and controller wiring.

Single-doser test arrangement with scale, screen, and controller wiring.

[Original source](https://docs.google.com/document/d/1T77pfLAAVP4tJ4OaOJhaz1ho2cAGb-1LFiVUrzH-hzI/edit)

## m2_5.jpg

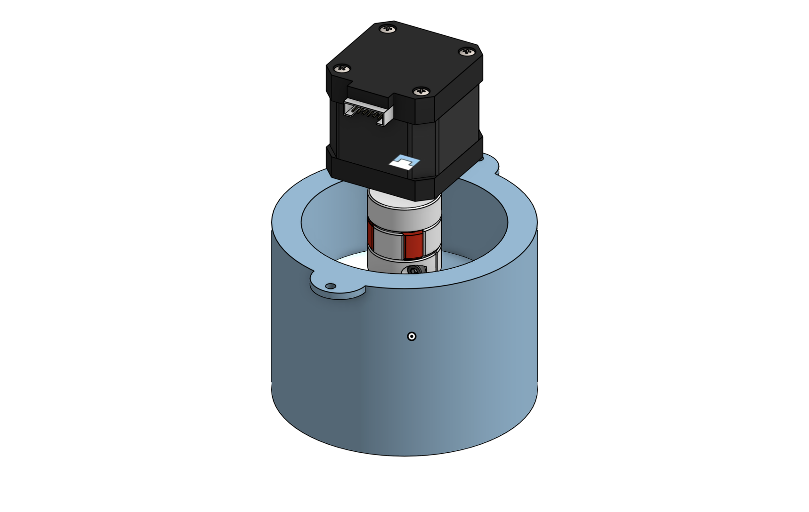
[picture p62: docs/journal-reference/assets/m2_5.jpg]
CAD showing the motor mounted above a single hopper.


CAD showing the motor mounted above a single hopper.

[Original source](https://docs.google.com/document/d/1T77pfLAAVP4tJ4OaOJhaz1ho2cAGb-1LFiVUrzH-hzI/edit)

## m4_1.jpg

Later open rotary structure with upper and lower plates and spacers.

Later open rotary structure with upper and lower plates and spacers.

[Original source](https://docs.google.com/document/d/1j8LOm5HRvMM-VXsni-38hi5GsA0yg5A1A_3LY9DY1Is/edit)

## m4_2.jpg

Physical multi-doser assembly photograph included in M4.

Physical multi-doser assembly photograph included in M4.

[Original source](https://docs.google.com/document/d/1j8LOm5HRvMM-VXsni-38hi5GsA0yg5A1A_3LY9DY1Is/edit)

## m4_3.jpg

Earlier solid eight-cavity rotary disk for comparison with the open structure.

Earlier solid eight-cavity rotary disk for comparison with the open structure.

[Original source](https://docs.google.com/document/d/1j8LOm5HRvMM-VXsni-38hi5GsA0yg5A1A_3LY9DY1Is/edit)

## m4_4.jpg

Full frame, carousel, drive, and screen CAD from M4.

Full frame, carousel, drive, and screen CAD from M4.

[Original source](https://docs.google.com/document/d/1j8LOm5HRvMM-VXsni-38hi5GsA0yg5A1A_3LY9DY1Is/edit)

## photo_perfboard_comparison.jpg

IMG_8167.HEIC Drive preview: breadboard wiring beside an unsoldered perfboard. Supports the board-packaging discussion; does not show a completed failed perfboard circuit.

IMG_8167.HEIC Drive preview: breadboard wiring beside an unsoldered perfboard. Supports the board-packaging discussion; does not show a completed failed perfboard circuit.

[Original source](https://drive.google.com/file/d/1fuau6g7IH-GREJ9cu54vgH6rErYTzOjz/view)
