aaravs-s/pharmatech/JOURNAL.md

# Pill Compounder Journal

This file is the entry point for the project journal. Add completed entries written from actual work here, including their original work date, active time, progress images, and measured results.

## Personal retrospective journals

A separate collection of finished, AI-assisted retrospective narratives is available for personal documentation. These are not Forge submissions or verified session logs.

- [All 33 finished journals](docs/journals/README.md)
- [Read the complete collection in one document](docs/journals/ALL_JOURNALS.md)

## Reference material

The AI-assisted reference drafts and source-image gallery are stored separately for rewriting and fact-checking. They are not submitted journal entries or verified hours.

- [All 33 reference drafts](docs/journal-reference/README.md)
- [Image gallery](docs/journal-reference/GALLERY.md)
- [Direct image URLs for Markdown](docs/journal-reference/IMAGE_URLS.md)
- [Sources, test results, and version notes](docs/journal-reference/EVIDENCE.md)
- [Actual-session worksheet](docs/journal-reference/session_worksheet.csv)

## Adding images

The images are hosted as individual files in this public repository. For external Markdown editors, use their complete raw URLs, for example:

```markdown
![Archived auger flight sketch](https://raw.githubusercontent.com/aaravs-s/pharmatech/main/docs/journal-reference/assets/cad_v5_flight_sketch.jpg)
```

The CAD construction captures are retrospective views from archived models, captured on October 13, 2026. Label them accordingly when using them in an entry.

## Completed entries

<!-- Add your own completed entries below. Keep the reference drafts outside the submitted journal. -->
