aaravs-s/pharmatech/docs/journal-reference/IMAGE_URLS.md

# Image URLs for journal entries

These images are committed to this public repository. Use the complete raw URL when embedding an image on another website. External sites must allow remote images from raw.githubusercontent.com.

CAD construction views captured on October 13, 2026 are retrospective inspections of archived features. They do not establish original work dates or active hours.

| File | Direct image URL |
| --- | --- |
| `cad_b4_assembly.jpg` | https://raw.githubusercontent.com/aaravs-s/pharmatech/main/docs/journal-reference/assets/cad_b4_assembly.jpg |
| `cad_b4_lift.jpg` | https://raw.githubusercontent.com/aaravs-s/pharmatech/main/docs/journal-reference/assets/cad_b4_lift.jpg |
| `cad_doser_early_assembly.jpg` | https://raw.githubusercontent.com/aaravs-s/pharmatech/main/docs/journal-reference/assets/cad_doser_early_assembly.jpg |
| `cad_main_assembly.jpg` | https://raw.githubusercontent.com/aaravs-s/pharmatech/main/docs/journal-reference/assets/cad_main_assembly.jpg |
| `cad_main_rotary.jpg` | https://raw.githubusercontent.com/aaravs-s/pharmatech/main/docs/journal-reference/assets/cad_main_rotary.jpg |
| `cad_main_superstructure.jpg` | https://raw.githubusercontent.com/aaravs-s/pharmatech/main/docs/journal-reference/assets/cad_main_superstructure.jpg |
| `cad_v10_auger_agitator.jpg` | https://raw.githubusercontent.com/aaravs-s/pharmatech/main/docs/journal-reference/assets/cad_v10_auger_agitator.jpg |
| `cad_v18_adapter_base_extrude.jpg` | https://raw.githubusercontent.com/aaravs-s/pharmatech/main/docs/journal-reference/assets/cad_v18_adapter_base_extrude.jpg |
| `cad_v18_adapter_base_sketch.jpg` | https://raw.githubusercontent.com/aaravs-s/pharmatech/main/docs/journal-reference/assets/cad_v18_adapter_base_sketch.jpg |
| `cad_v18_adapter_complete.jpg` | https://raw.githubusercontent.com/aaravs-s/pharmatech/main/docs/journal-reference/assets/cad_v18_adapter_complete.jpg |
| `cad_v18_adapter_key_extrude.jpg` | https://raw.githubusercontent.com/aaravs-s/pharmatech/main/docs/journal-reference/assets/cad_v18_adapter_key_extrude.jpg |
| `cad_v18_adapter_key_sketch.jpg` | https://raw.githubusercontent.com/aaravs-s/pharmatech/main/docs/journal-reference/assets/cad_v18_adapter_key_sketch.jpg |
| `cad_v18_disk_complete.jpg` | https://raw.githubusercontent.com/aaravs-s/pharmatech/main/docs/journal-reference/assets/cad_v18_disk_complete.jpg |
| `cad_v18_disk_lightening.jpg` | https://raw.githubusercontent.com/aaravs-s/pharmatech/main/docs/journal-reference/assets/cad_v18_disk_lightening.jpg |
| `cad_v18_disk_mirror.jpg` | https://raw.githubusercontent.com/aaravs-s/pharmatech/main/docs/journal-reference/assets/cad_v18_disk_mirror.jpg |
| `cad_v18_disk_plane.jpg` | https://raw.githubusercontent.com/aaravs-s/pharmatech/main/docs/journal-reference/assets/cad_v18_disk_plane.jpg |
| `cad_v18_disk_plate.jpg` | https://raw.githubusercontent.com/aaravs-s/pharmatech/main/docs/journal-reference/assets/cad_v18_disk_plate.jpg |
| `cad_v18_disk_sketch.jpg` | https://raw.githubusercontent.com/aaravs-s/pharmatech/main/docs/journal-reference/assets/cad_v18_disk_sketch.jpg |
| `cad_v18_frame_baseplates.jpg` | https://raw.githubusercontent.com/aaravs-s/pharmatech/main/docs/journal-reference/assets/cad_v18_frame_baseplates.jpg |
| `cad_v18_frame_complete.jpg` | https://raw.githubusercontent.com/aaravs-s/pharmatech/main/docs/journal-reference/assets/cad_v18_frame_complete.jpg |
| `cad_v18_frame_rails.jpg` | https://raw.githubusercontent.com/aaravs-s/pharmatech/main/docs/journal-reference/assets/cad_v18_frame_rails.jpg |
| `cad_v18_frame_sketch.jpg` | https://raw.githubusercontent.com/aaravs-s/pharmatech/main/docs/journal-reference/assets/cad_v18_frame_sketch.jpg |
| `cad_v18_frame_uprights.jpg` | https://raw.githubusercontent.com/aaravs-s/pharmatech/main/docs/journal-reference/assets/cad_v18_frame_uprights.jpg |
| `cad_v1_adapter_extrude.jpg` | https://raw.githubusercontent.com/aaravs-s/pharmatech/main/docs/journal-reference/assets/cad_v1_adapter_extrude.jpg |
| `cad_v1_complete.jpg` | https://raw.githubusercontent.com/aaravs-s/pharmatech/main/docs/journal-reference/assets/cad_v1_complete.jpg |
| `cad_v1_feeder.jpg` | https://raw.githubusercontent.com/aaravs-s/pharmatech/main/docs/journal-reference/assets/cad_v1_feeder.jpg |
| `cad_v1_feeder_revolve.jpg` | https://raw.githubusercontent.com/aaravs-s/pharmatech/main/docs/journal-reference/assets/cad_v1_feeder_revolve.jpg |
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
| `m4_4.jpg` | https://raw.githubusercontent.com/aaravs-s/pharmatech/main/docs/journal-reference/assets/m4_4.jpg |
| `photo_perfboard_comparison.jpg` | https://raw.githubusercontent.com/aaravs-s/pharmatech/main/docs/journal-reference/assets/photo_perfboard_comparison.jpg |
