aaravs-s/pharmatech/(commit log)

2026-06-09 Add boilerplate CAD firmware electronics structure
2026-06-27 Add stepper motor control code using AccelStepper
